cherry-takuan/NLP_VGA/font/README.md

# NLP_VGA用フォントデータ

美咲フォントベースの8x8フォント
ROM U6 に書き込んで使う

SST39SF010のピンアサインをミスって基板上のデータバス，アドレスバス共に上位下位が逆になっているため，このデータをデータ，アドレスともに逆順にしてから書き込む
