cherry-takuan/NLP_VGA/(commit log)

2025-02-02 暫定回路
    [VGA.kicad_pcb, VGA.kicad_sch, interface.kicad_sch, video.kicad_sch]
2025-02-04 だいたい完成
    [VGA.kicad_pcb, VGA.kicad_sch, interface.kicad_sch, video.kicad_sch]
2025-02-04 フォントテーブル追加
2025-02-04 システムROM追加
2025-02-04 フォントテーブル修正
2025-02-06 信号生成部設計完了
    [VGA.kicad_pcb, VGA.kicad_sch, bom.csv, designators.csv, interface.kicad_sch, positions.csv, video.kicad_sch]
2025-02-06 電源ライン増強他
    [VGA.kicad_pcb, video.kicad_sch]
2025-02-06 内部バスプルアップ追加他/基板製造バージョン
    [VGA.kicad_pcb, VGA.kicad_sch, bom.csv, designators.csv, interface.kicad_sch, positions.csv, video.kicad_sch]
2025-02-28 VGAの入出力インターフェイス修正
    [VGA.kicad_pcb, interface.kicad_sch, video.kicad_sch]
2025-02-28 VRAMアクセス中の出力イネーブルを追加
    [VGA.kicad_pcb, VGA.kicad_sch, video.kicad_sch]
